ollieelliot/ESP32-IoT-Board/New layout/Layer1_v3_print.pdf

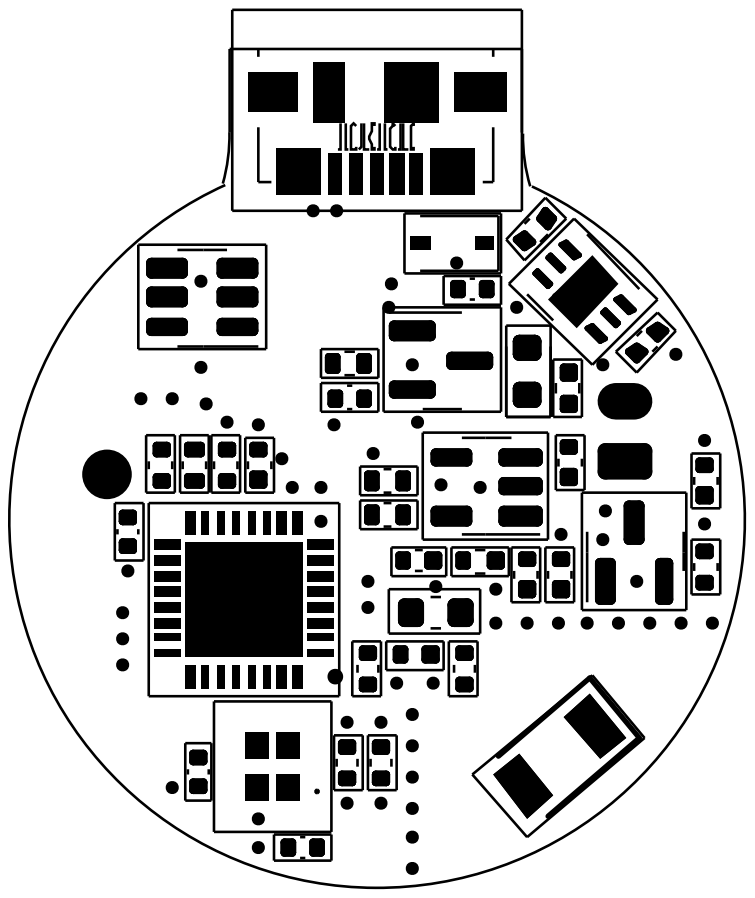
[picture p1: page 1]
