ollieelliot/ESP32-IoT-Board/New layout/Layer1_v2_print.pdf

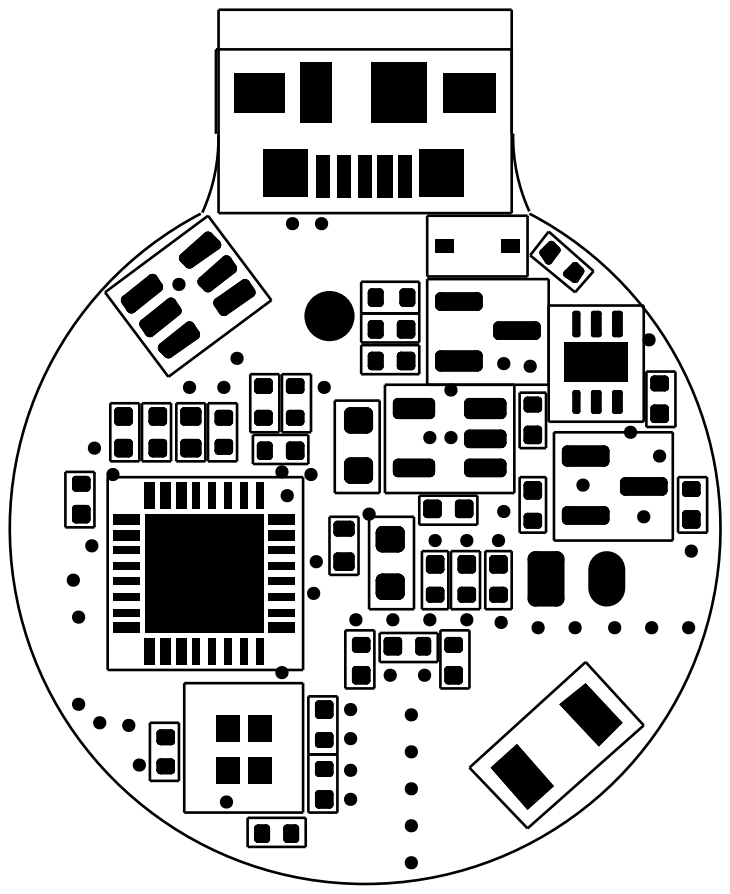
[picture p2: page 1]
