ollieelliot/ESP32-IoT-Board/New layout/Layer1_v1_print.pdf

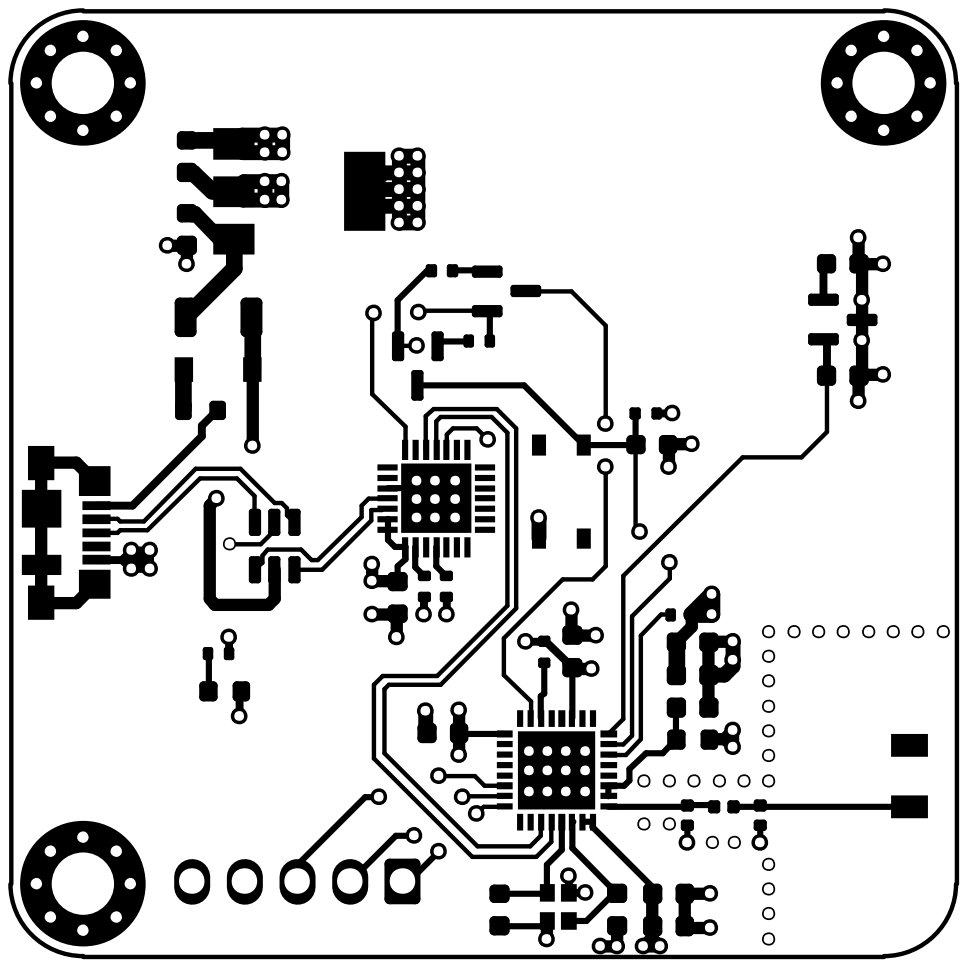
[picture p3: page 1]
