ollieelliot/ESP32-IoT-Board/New layout/ESP32-IoT-Board-ChipAnt.kicad_pcb

## KiCad design New layout/ESP32-IoT-Board-ChipAnt.kicad_pcb (2023-01-26)

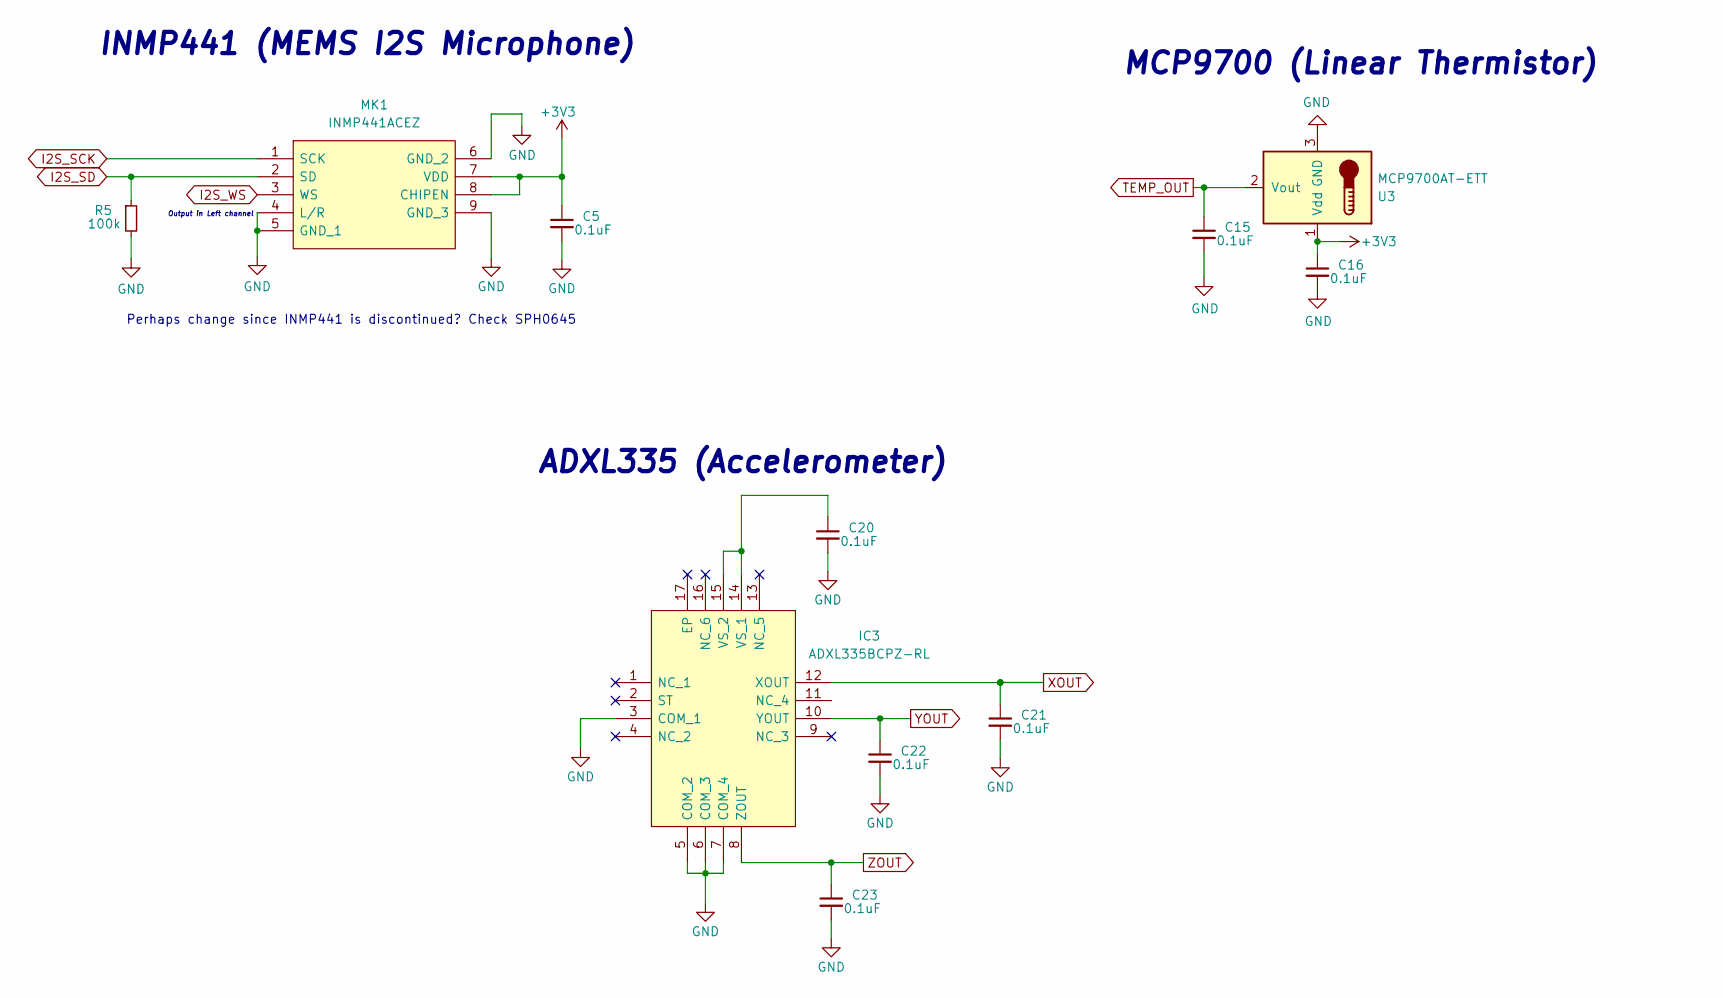
[picture p4: schematic Sensors.kicad_sch]

Parts:
C5, C15, C16, C20, C21, C22, C23: 0.1uF; C_0402_1005Metric
IC3: ADXL335BCPZ-RL; LFCSP-16-1EP_4x4mm_P0.65mm_EP2.1x2.1mm; Manufacturer_Part_Number ADXL335BCPZ-RL; Mouser Part Number 584-ADXL335BCPZ-R
MK1: INMP441ACEZ; Manufacturer_Part_Number INMP441ACEZ
R5: 100k; R_0402_1005Metric
U3: MCP9700AT-ETT; SOT-23

Connections:
+3V3: C5.1, C16.1, MK1.7 (VDD), MK1.8 (CHIPEN), U3.1 (Vdd); also elsewhere on the board
GND: C5.2, C15.2, C16.2, C20.2, C21.2, C22.2, C23.2, IC3.3 (COM_1), IC3.5 (COM_2), IC3.6 (COM_3), IC3.7 (COM_4), MK1.4 (L/R), MK1.5 (GND_1), MK1.6 (GND_2), MK1.9 (GND_3), R5.2, U3.3 (GND); also elsewhere on the board
I2S_SCK: MK1.1 (SCK); also elsewhere on the board
I2S_SD: MK1.2 (SD), R5.1; also elsewhere on the board
I2S_WS: MK1.3 (WS); also elsewhere on the board
unnamed: C20.1, IC3.14 (VS_1), IC3.15 (VS_2)
TEMP_OUT: C15.1, U3.2 (Vout); also elsewhere on the board
XOUT: C21.1, IC3.12 (XOUT); also elsewhere on the board
YOUT: C22.1, IC3.10 (YOUT); also elsewhere on the board
ZOUT: C23.1, IC3.8 (ZOUT); also elsewhere on the board

Notes on the sheet:
MCP9700 (Linear Thermistor)
ADXL335 (Accelerometer)
INMP441 (MEMS I2S Microphone)
Output in Left channel
Perhaps change since INMP441 is discontinued? Check SPH0645

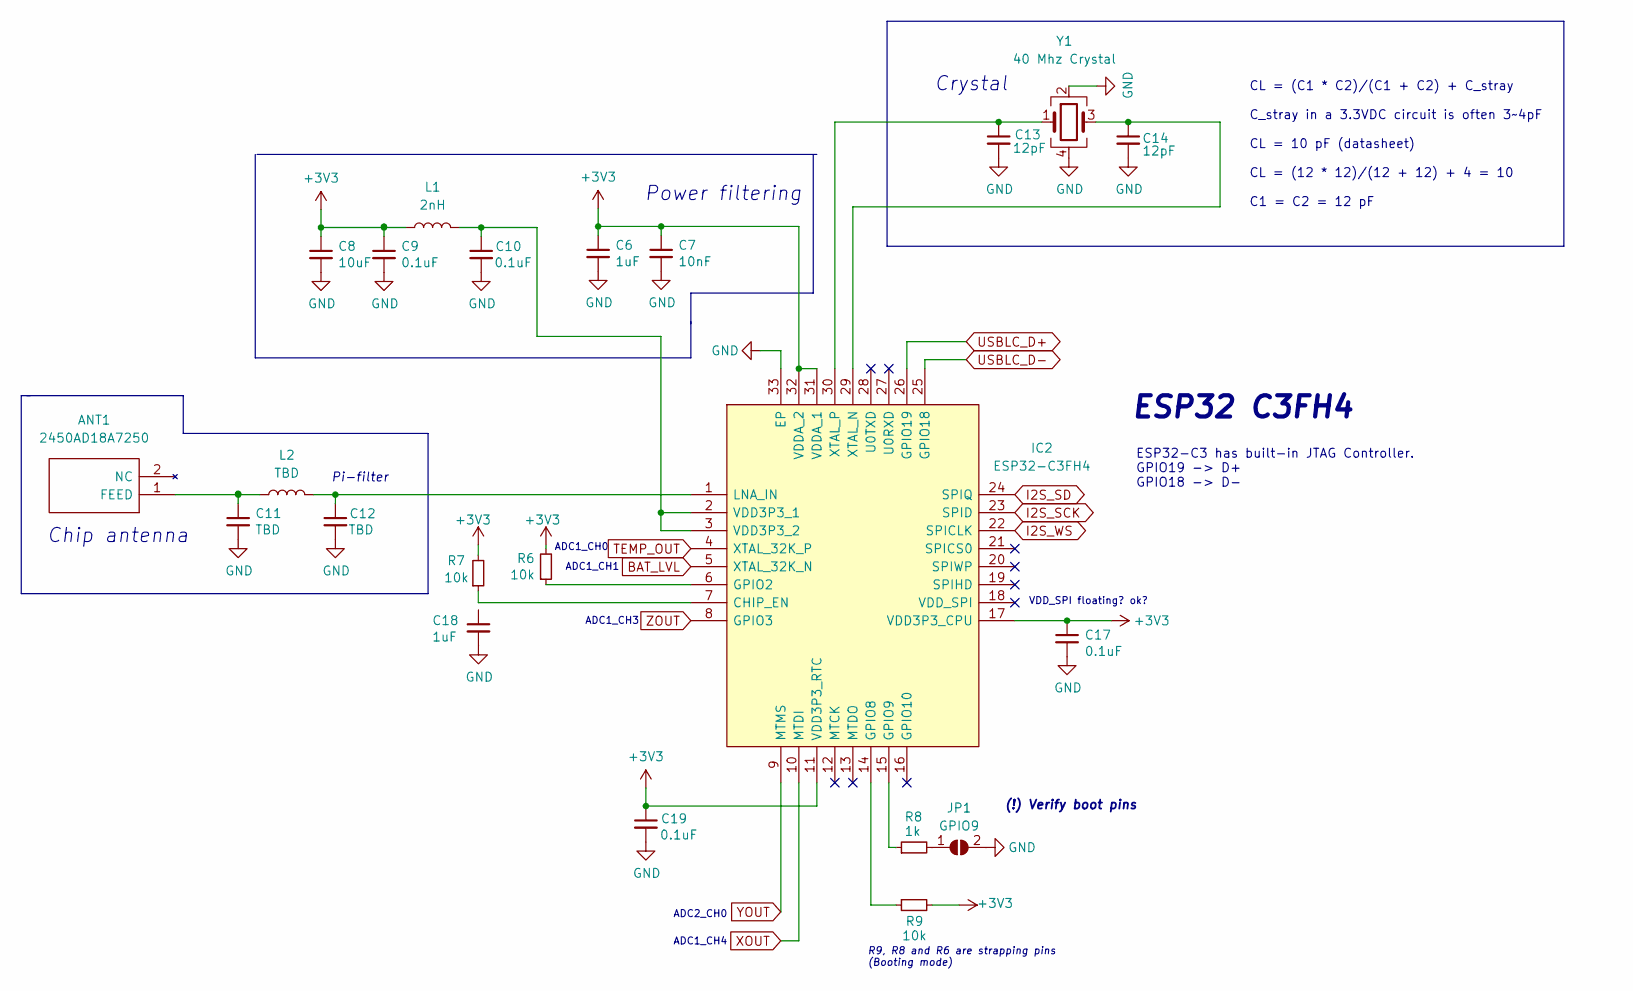
[picture p5: schematic MCU.kicad_sch]

Parts:
ANT1: 2450AD18A7250; ANTC3216X60N; Manufacturer_Part_Number 2450AD18A7250; Mouser Part Number 609-2450AD18A7250
C6, C18: 1uF; C_0402_1005Metric
C7: 10nF; C_0402_1005Metric
C8: 10uF; C_0402_1005Metric
C9, C10, C17, C19: 0.1uF; C_0402_1005Metric
C11, C12: TBD; C_0402_1005Metric
C13, C14: 12pF; C_0402_1005Metric
IC2: ESP32-C3FH4; QFN50P500X500X90-33N-D; Manufacturer_Part_Number ESP32-C3FH4; Mouser Part Number 356-ESP32-C3FH4
JP1: GPIO9; R_0402_1005Metric
L1: 2nH; L_0603_1608Metric
L2: TBD; L_0402_1005Metric
R6, R7, R9: 10k; R_0402_1005Metric
R8: 1k; R_0402_1005Metric
Y1: 40 Mhz Crystal; ECS4001037B2CKMTR

Connections:
+3V3: C6.1, C7.1, C8.1, C9.1, C17.1, C19.1, IC2.11 (VDD3P3_RTC), IC2.17 (VDD3P3_CPU), IC2.31 (VDDA_1), IC2.32 (VDDA_2), L1.1, R6.2, R7.2, R9.2; also elsewhere on the board
BAT_LVL: IC2.5 (XTAL_32K_N); also elsewhere on the board
GND: C6.2, C7.2, C8.2, C9.2, C10.2, C11.2, C12.2, C13.2, C14.2, C17.2, C18.2, C19.2, IC2.33 (EP), JP1.2 (B), Y1.2, Y1.4; also elsewhere on the board
I2S_SCK: IC2.23 (SPID); also elsewhere on the board
I2S_SD: IC2.24 (SPIQ); also elsewhere on the board
I2S_WS: IC2.22 (SPICLK); also elsewhere on the board
unnamed: ANT1.1 (FEED), C11.1, L2.1
unnamed: C10.1, IC2.2 (VDD3P3_1), IC2.3 (VDD3P3_2), L1.2
unnamed: C12.1, IC2.1 (LNA_IN), L2.2
unnamed: C13.1, IC2.30 (XTAL_P), Y1.1
unnamed: C14.1, IC2.29 (XTAL_N), Y1.3
unnamed: IC2.6 (GPIO2), R6.1
unnamed: IC2.7 (CHIP_EN), R7.1
unnamed: IC2.14 (GPIO8), R9.1
unnamed: IC2.15 (GPIO9), R8.1
unnamed: JP1.1 (A), R8.2
TEMP_OUT: IC2.4 (XTAL_32K_P); also elsewhere on the board
USBLC_D+: IC2.26 (GPIO19); also elsewhere on the board
USBLC_D-: IC2.25 (GPIO18); also elsewhere on the board
XOUT: IC2.10 (MTDI); also elsewhere on the board
YOUT: IC2.9 (MTMS); also elsewhere on the board
ZOUT: IC2.8 (GPIO3); also elsewhere on the board

Notes on the sheet:
CL = (C1 * C2)/(C1 + C2) + C_stray C_stray in a 3.3VDC circuit is often 3~4pF CL = 10 pF (datasheet) CL = (12 * 12)/(12 + 12) + 4 = 10 C1 = C2 = 12 pF
ESP32-C3 has built-in JTAG Controller. GPIO19 -> D+ GPIO18 -> D-
ADC2_CH0
Crystal
(!) Verify boot pins
ADC1_CH4
ADC1_CH1
ESP32 C3FH4
Pi-filter
Power filtering
Chip antenna
VDD_SPI floating? ok?
ADC1_CH0
R9, R8 and R6 are strapping pins (Booting mode)
ADC1_CH3

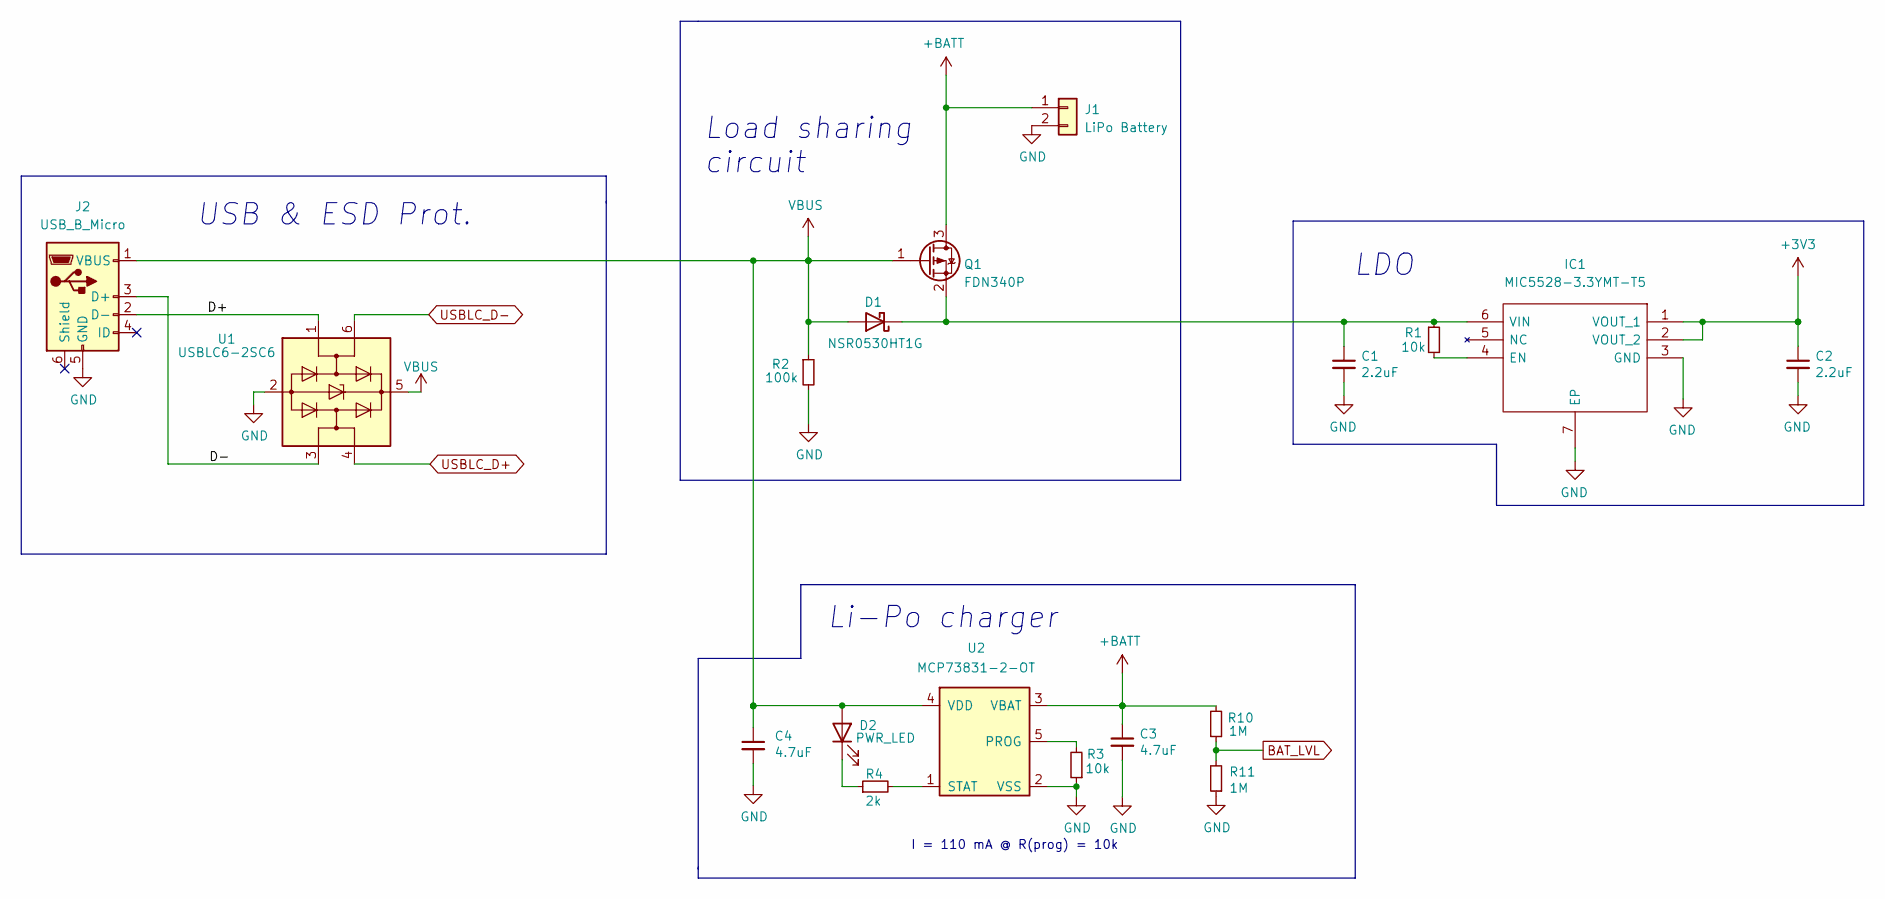
[picture p6: schematic power.kicad_sch]

Parts:
C1, C2: 2.2uF; C_0402_1005Metric
C3, C4: 4.7uF; C_0402_1005Metric
D1: NSR0530HT1G; D_SOD-323
D2: PWR_LED; LED_0603_1608Metric
IC1: MIC5528-3.3YMT-T5; TDFN-6-1EP_2.5x2.5mm_P0.65mm_EP1.3x2mm; Manufacturer_Part_Number MIC5528-3.3YMT-T5; Mouser Part Number 998-MIC5528-3.3YMTT5
J1: LiPo Battery; JST_PH_S2B-PH-K_1x02_P2.00mm_Horizontal
J2: USB_B_Micro; USB_Micro-B_Molex_47346-0001
Q1: FDN340P; SOT-23
R1, R3: 10k; R_0402_1005Metric
R2: 100k; R_0402_1005Metric
R4: 2k; R_0402_1005Metric
R10, R11: 1M; R_0402_1005Metric
U1: USBLC6-2SC6; SOT-23-6
U2: MCP73831-2-OT; SOT-23-5

Connections:
+3V3: C2.1, IC1.1 (VOUT_1), IC1.2 (VOUT_2); also elsewhere on the board
+BATT: C3.1, J1.1, Q1.3 (D), R10.2, U2.3 (VBAT)
/USB & Power/D+: J2.2 (D-), U1.1 (I/O1)
/USB & Power/D-: J2.3 (D+), U1.3 (I/O2)
BAT_LVL: R10.1, R11.2; also elsewhere on the board
GND: C1.2, C2.2, C3.2, C4.2, IC1.3 (GND), IC1.7 (EP), J1.2, J2.5 (GND), R2.2, R3.1, R11.1, U1.2 (GND), U2.2 (VSS); also elsewhere on the board
unnamed: C1.1, D1.1 (K), IC1.6 (VIN), Q1.2 (S), R1.1
unnamed: D2.1 (K), R4.1
unnamed: IC1.4 (EN), R1.2
unnamed: R3.2, U2.5 (PROG)
unnamed: R4.2, U2.1 (STAT)
USBLC_D+: U1.4 (I/O2); also elsewhere on the board
USBLC_D-: U1.6 (I/O1); also elsewhere on the board
VBUS: C4.1, D1.2 (A), D2.2 (A), J2.1 (VBUS), Q1.1 (G), R2.1, U1.5 (VBUS), U2.4 (VDD)

Notes on the sheet:
Li-Po charger
I = 110 mA @ R(prog) = 10k
USB & ESD Prot.
LDO
Load sharing circuit

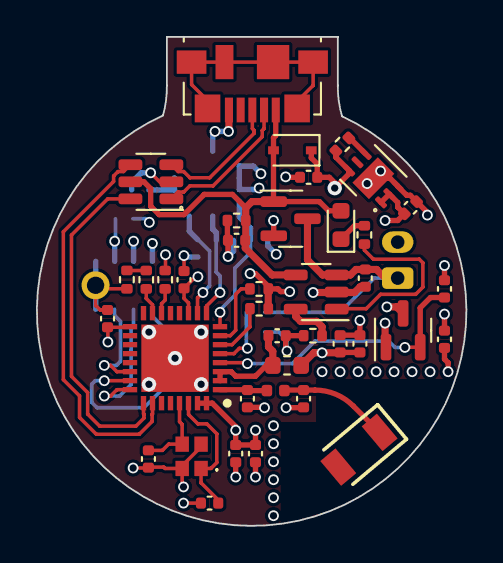
[picture p7: board ESP32-IoT-Board-ChipAnt.kicad_pcb from above]

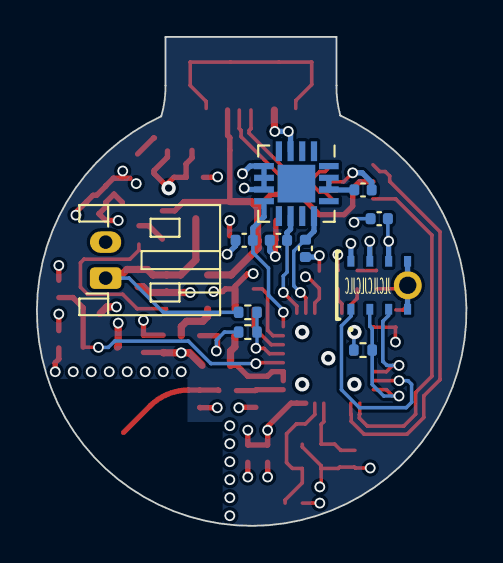
[picture p8: board ESP32-IoT-Board-ChipAnt.kicad_pcb from below]

Board: 4 copper layers, 23.9 x 27.2 mm, 50 parts (11 on the bottom side), 32 nets.
