ollieelliot/ESP32-IoT-Board/(commit log)

2022-02-27 Added IMP441 MEMS Microphone
    [ESP32-IoT-Board.kicad_sch]
2022-03-12 Added thermistor and continued to add necessary components
    [ESP32-IoT-Board.sch]
2022-03-16 Initial commit of new circuit
    [ESP32-IoT-Board-ChipAnt.kicad_pcb, ESP32-IoT-Board-ChipAnt.kicad_sch, ESP32-IoT-Board.kicad_pcb, ESP32-IoT-Board.kicad_sch, ESP32-IoT-Board.sch]
2022-03-31 First draft of PCB
    [ESP32-IoT-Board-ChipAnt.kicad_pcb]
2022-12-12 Changed almost everything
    [ESP32-IoT-Board-ChipAnt.kicad_pcb, ESP32-IoT-Board-ChipAnt.kicad_sch, MCU.kicad_sch, Sensors.kicad_sch, untitled.kicad_sch]
2022-12-14 Added accelerometer
    [ESP32-IoT-Board-ChipAnt.kicad_pcb, ESP32-IoT-Board-ChipAnt.kicad_sch, MCU.kicad_sch, Sensors.kicad_sch]
2022-12-20 Made new layout
    [ESP32-IoT-Board-ChipAnt.kicad_pcb, ESP32-IoT-Board-ChipAnt.kicad_sch, MCU.kicad_sch, Sensors.kicad_sch, untitled.kicad_sch]
2022-12-20 New layout
    [ESP32-IoT-Board-ChipAnt.kicad_pcb, ESP32-IoT-Board-ChipAnt.kicad_sch, MCU.kicad_sch, Sensors.kicad_sch, power.kicad_sch]
